CountingLogic/ECG-Verilog-FPGA/README.md

# ECG-Verilog-FPGA
An accurate Electro Cardio Gram system, with peak detection and counting mechanism programmed in Verilog and implimented in Xilinx-FPGA. 

The entire code and the analogue steps involved in heart beat processing are explained in the Final Project report (the only pdf file in this repo)
